whkolath/TerraTek/Documents/Schematic/TerraTek_Schematic.pdf

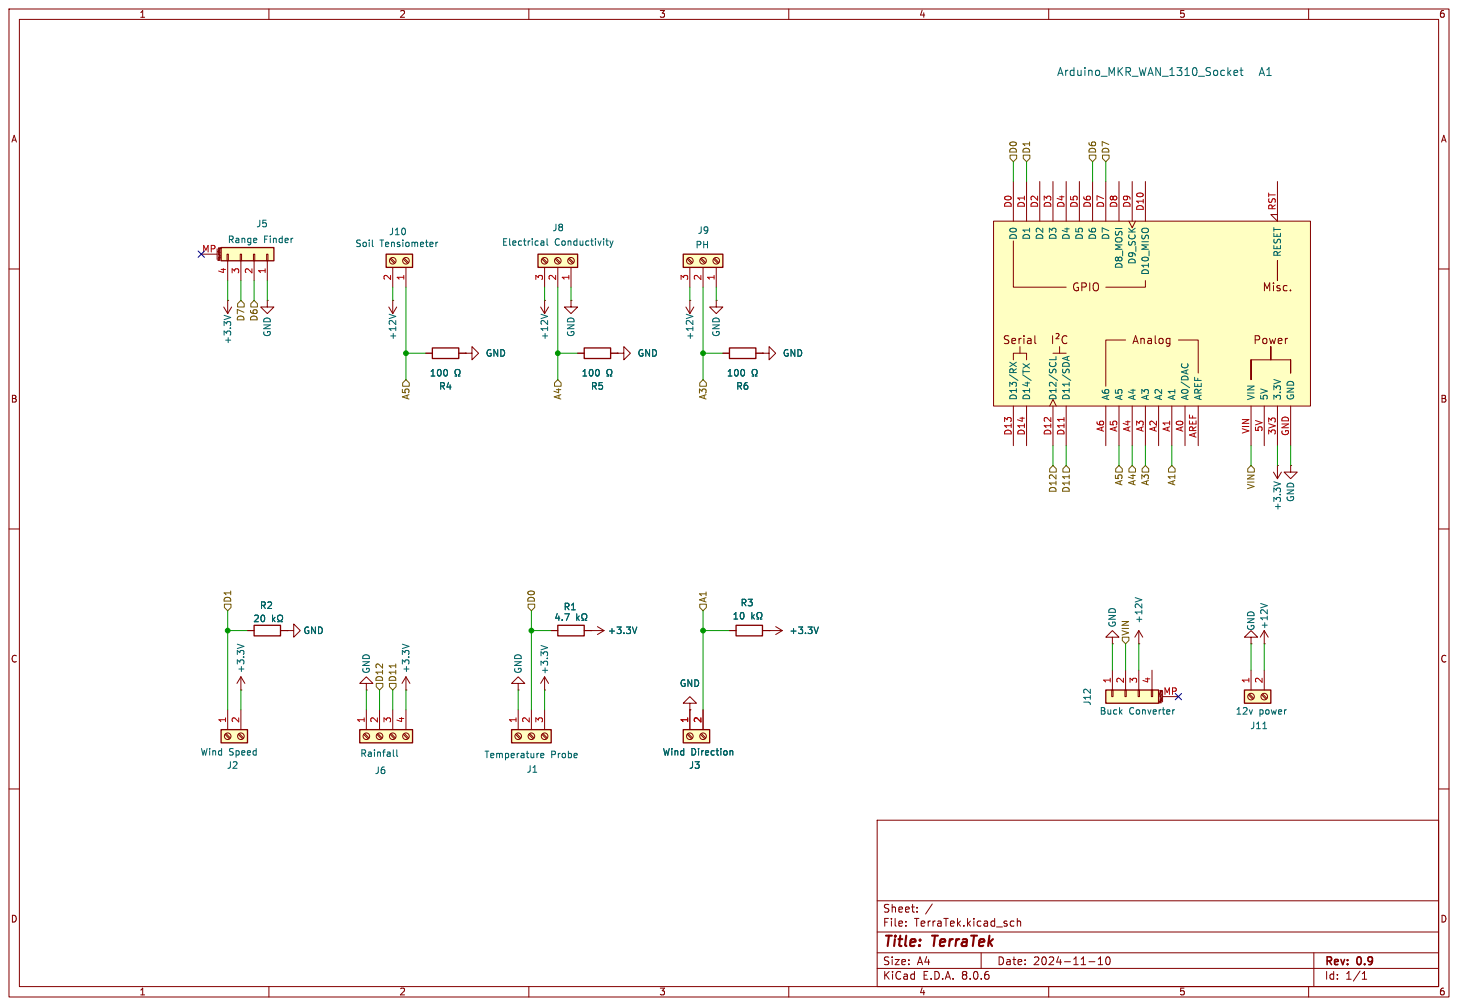
[picture p51: page 1]
