whkolath/TerraTek/Arduino/First_Run/First_Run.ino

#include <MKRWAN.h>

LoRaModem modem;

void setup() {
  // put your setup code here, to run once:
  Serial.begin(115200);
  while (!Serial);
  Serial.println("Welcome to MKR WAN 1300/1310 first configuration sketch");
  // change this to your regional band (eg. US915, AS923, ...)
  if (!modem.begin(US915)) {
    Serial.println("Failed to start module");
    while (1) {}
  };
  Serial.print("Your module version is: ");
  Serial.println(modem.version());
  if (modem.version() != ARDUINO_FW_VERSION) {
    Serial.println("Please make sure that the latest modem firmware is installed.");
    Serial.println("To update the firmware upload the 'MKRWANFWUpdate_standalone.ino' sketch.");
  }
  Serial.print("Your device EUI is: ");
  Serial.println(modem.deviceEUI());
}

void loop() {
}
